threedaymonk/footswitch/hardware/footswitch.kicad_sch

## KiCad design hardware/footswitch.kicad_sch (2023-08-09)

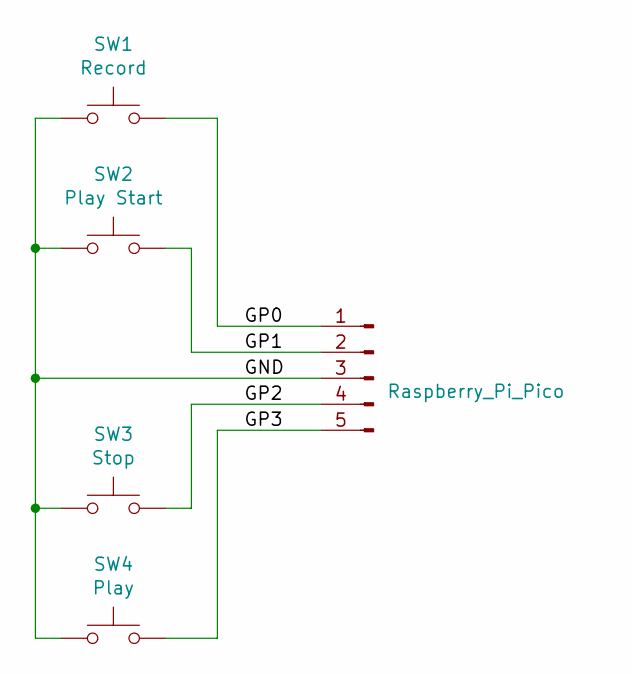
[picture p1: schematic footswitch.kicad_sch]

Parts:
J1: Raspberry_Pi_Pico
SW1: Record
SW2: Play Start
SW3: Stop
SW4: Play

Connections:
GND: J1.3, SW1.1, SW2.1, SW3.1, SW4.1
GP0: J1.1, SW1.2
GP1: J1.2, SW2.2
GP2: J1.4, SW3.2
GP3: J1.5, SW4.2
