threedaymonk/footswitch/(commit log)

2020-07-03 Correctly frame sysex messages
2020-07-03 Specify board rather than bare MCU
    I don't know if this actually makes a difference.
2020-07-03 Make button 2 Play Start
2020-07-03 Keep working Teensy USB MIDI name
    The MPC doesn't like it if I change it.
2020-07-03 Stop and reset for PLAY START
    This behaves more like the hardware button.
2020-08-03 Add 3D models and details
    [footswitch-washer.scad, teensy-2.0-holder.scad]
2020-08-04 Clarify pin assignments
2021-02-21 Add schematic
    [footswitch.sch]
2021-02-21 Add schematic to README
2021-02-21 Add Arduino support
    Might make it easier for people.
2021-02-21 Commit STL files for convenience
    [footswitch-washer.stl, teensy-2.0-holder.stl]
2023-08-04 Remove Teensy hardware
    [teensy-2.0-holder.scad, teensy-2.0-holder.stl]
2023-08-04 Add model for bezel around USB connector
    [usb-bezel.scad]
2023-08-04 Add template for drilling for USB
    [usb-drill-template.scad]
2023-08-05 Add frame to mount Pi Pico
    [pico-mount.scad]
2023-08-05 Add spacer to assist in setting switch height
    [switch-spacer.scad]
2023-08-05 Ad Makefile to generate STL files
2023-08-05 Add bracket for quick repeatable foot alignment
    [foot-aligner.scad]
2023-08-05 Remove unnecessary washer
    [footswitch-washer.scad, footswitch-washer.stl]
2023-08-05 Ignore generated STL
2023-08-05 Port code to Raspberry Pi Pico with PlatformIO
2023-08-06 Set MIDI device name
2023-08-06 Correct logic of buttons (switched to ground)
    [Button.cpp, Button.h, main.cpp]
2023-08-09 Update schematic
    [footswitch.kicad_sch, footswitch.sch]
